dyu134/Paper-Apps-Player/production/bom.csv

Designator | Footprint | Quantity | Value | LCSC Part #
BT1 | Molex_PicoBlade_53048-0210_1x02_P1.25mm_Horizontal | 1 | Battery_Cell
C1 | 0603 | 1 | 15p
C10, C11, C12, C15, C18, C3, C4, C5, C9, L1 | 0603 | 10 | 10u
C13, C2, C6, C7, C8 | 0603 | 5 | 1u
C14 | 0603 | 1 | 0u1
C16, C17 | 0603 | 2 | 4u7
C19, C20 | 0603 | 2 | 100n
D2 | SOT-666 | 1 | USBLC6-2P6
D3 | 0603 | 1 | ORANGE
D4 | 0603 | 1 | RED
D5 | SOT-23 | 1 | BAT54S
D6, D7, D8 | D_SOD-123 | 3 | MBR0530T1G
D9 | LED_WS2812B_PLCC4_5.0x5.0mm_P3.2mm | 1 | WS2812B
J1 | USB_C_Receptacle_HCTL_HC-TYPE-C-16P-01A | 1 | USB_C_Receptacle_USB2.0_14P
J2 | Hirose_FH12-24S-0.5SH_1x24-1MP_P0.50mm_Horizontal | 1 | Conn_01x24_MountingPin
J3 | microSD_HC_Hirose_DM3AT-SF-PEJM5 | 1 | Micro_SD_Card_Det_Hirose_DM3AT
J4 | PinHeader_1x09_P2.54mm_Vertical | 1 | Conn_01x09
Q1 | SOT-723 | 1 | NTK3139P
Q2 | SOT-323_SC-70 | 1 | Si1308EDL
R1, R2 | 0402 | 2 | 10k
R11, R13 | 0603 | 2 | 100k
R12 | 0603 | 1 | 2k1
R14 | 0603 | 1 | 33k
R15 | 0603 | 1 | 1M
R16 | 0603 | 1 | 0R47
R17, R18, R19, R20, R21, R22, R8 | 0603 | 7 | 10k
R3, R4 | 0603 | 2 | 5k1
R5, R6 | 0603 | 2 | 4k7
R7, R9 | 0603 | 2 | 3k3
RN1, RN2 | R_Array_Convex_8x0602 | 2 | 10k
SW1, SW2 | SW_Push_1P1T_NO_Vertical_Wuerth_434133025816 | 2 | SKRPACE010
SW10, SW5, SW6, SW7, SW8, SW9 | SW_SPST_SKQG_WithStem | 6 | SW_Push
SW3 | SIQ-02FVS3 | 1 | SIQ-02FVS3
SW4 | SW_SPDT_CK_JS102011SAQN | 1 | JS102011SAQN
U1 | ESP32-S3-WROOM-1 | 1 | ESP32-S3-WROOM-1
U2, U4 | SOT-23-5 | 2 | MAX40200AUK
U3 | SOT-23-5_HandSoldering | 1 | TP4065
U5 | YHE-YG16-001_SH1B166A1 | 1 | YHE-YG16-001_SH1B166A1
U6 | SOT-23-5 | 1 | TLV75733PDBV
U7 | SSOP-20_5.3x7.2mm_P0.65mm | 1 | MCP23008-xSS
