dyu134/Paper-Apps-Player/Paper Apps Player.kicad_pcb

## KiCad design Paper Apps Player.kicad_pcb (2026-11-13)

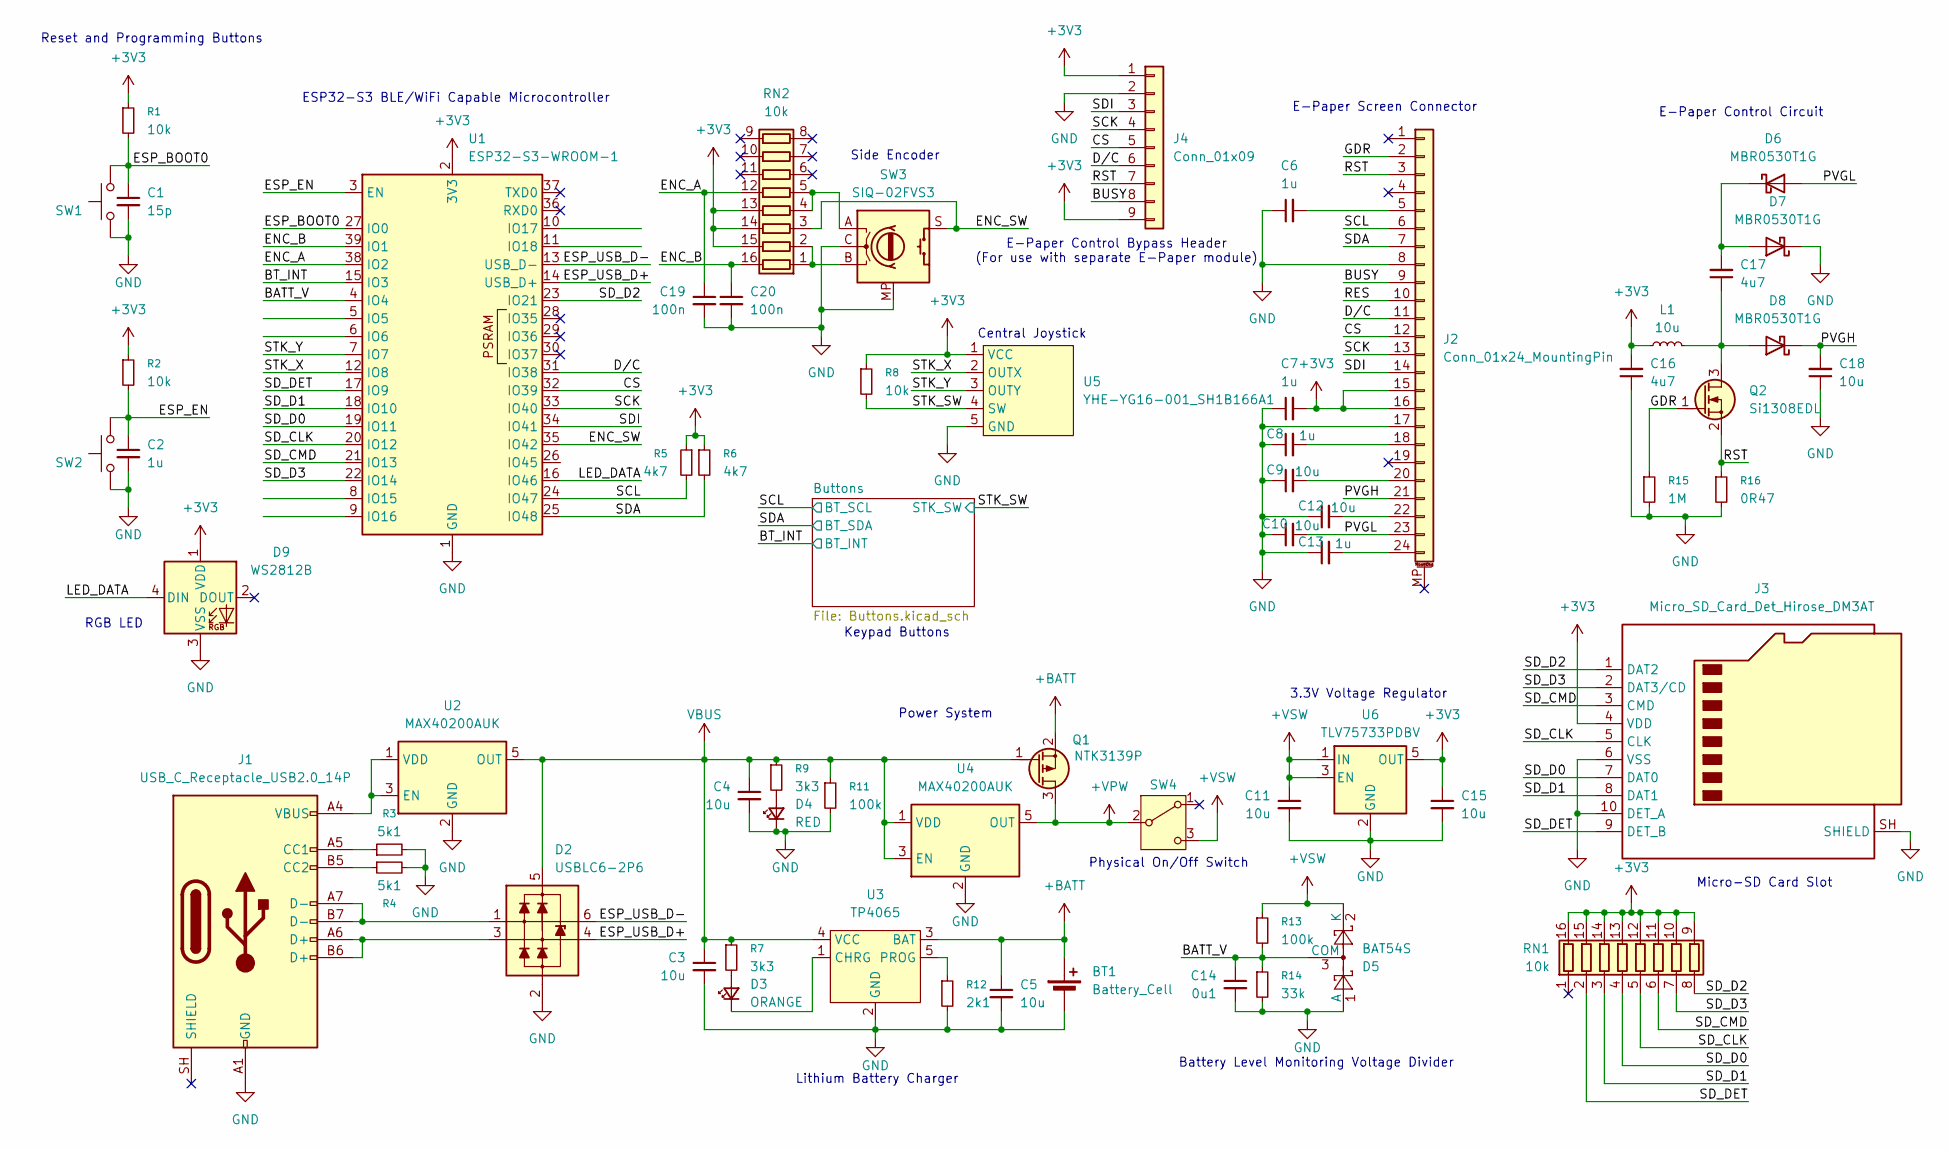
[picture p1: schematic Paper Apps Player.kicad_sch]

Parts:
BT1: Battery_Cell; Molex_PicoBlade_53048-0210_1x02_P1.25mm_Horizontal
C1: 15p; C_0603_1608Metric
C2, C6, C7, C8, C13: 1u; C_0603_1608Metric
C3, C4, C5, C9, C10, C11, C12, C15, C18: 10u; C_0603_1608Metric
C14: 0u1; C_0603_1608Metric
C16, C17: 4u7; C_0603_1608Metric
C19, C20: 100n; C_0603_1608Metric
D2: USBLC6-2P6; SOT-666
D3: ORANGE; LED_0603_1608Metric
D4: RED; LED_0603_1608Metric
D5: BAT54S; SOT-23
D6, D7, D8: MBR0530T1G; D_SOD-123
D9: WS2812B; LED_WS2812B_PLCC4_5.0x5.0mm_P3.2mm
J1: USB_C_Receptacle_USB2.0_14P; USB_C_Receptacle_HCTL_HC-TYPE-C-16P-01A
J2: Conn_01x24_MountingPin; Hirose_FH12-24S-0.5SH_1x24-1MP_P0.50mm_Horizontal
J3: Micro_SD_Card_Det_Hirose_DM3AT; microSD_HC_Hirose_DM3AT-SF-PEJM5
J4: Conn_01x09; PinHeader_1x09_P2.54mm_Vertical
L1: 10u; L_0603_1608Metric
Q1: NTK3139P; SOT-723
Q2: Si1308EDL; SOT-323_SC-70
R1, R2: 10k; R_0402_1005Metric
R3, R4: 5k1; R_0603_1608Metric
R5, R6: 4k7; R_0603_1608Metric
R7, R9: 3k3; R_0603_1608Metric
R8: 10k; R_0603_1608Metric
R11, R13: 100k; R_0603_1608Metric
R12: 2k1; R_0603_1608Metric
R14: 33k; R_0603_1608Metric
R15: 1M; R_0603_1608Metric
R16: 0R47; R_0603_1608Metric
RN1, RN2: 10k; R_Array_Convex_8x0602
SW1, SW2: SKRPACE010; SW_Push_1P1T_NO_Vertical_Wuerth_434133025816
SW3: SIQ-02FVS3
SW4: JS102011SAQN; SW_SPDT_CK_JS102011SAQN
U1: ESP32-S3-WROOM-1
U2, U4: MAX40200AUK; SOT-23-5
U3: TP4065; SOT-23-5_HandSoldering
U5: YHE-YG16-001_SH1B166A1
U6: TLV75733PDBV; SOT-23-5

Connections:
+3V3: C7.2, C15.1, C16.2, D9.1 (VDD), J2.15, J2.16, J3.4 (VDD), J4.1, J4.9, L1.1, R1.1, R2.1, R5.1, R6.1, R8.1, RN1.9 (R8.2), RN1.10 (R7.2), RN1.11 (R6.2), RN1.12 (R5.2), RN1.13 (R4.2), RN1.14 (R3.2), RN1.15 (R2.2), RN1.16 (R1.2), RN2.13 (R4.2), RN2.14 (R3.2), RN2.15 (R2.2), U1.2 (3V3), U5.1 (VCC), U6.5 (OUT); also elsewhere on the board
+BATT: BT1.1 (+), C5.1, Q1.2 (S), U3.3 (BAT)
+VPW: Q1.3 (D), SW4.2 (B), U4.5 (OUT)
+VSW: C11.1, D5.2 (K), R13.1, SW4.3 (C), U6.1 (IN), U6.3 (EN)
/BATT_V: C14.1, D5.3 (COM), R13.2, R14.1, U1.4 (IO4)
/BT_INT: U1.15 (IO3); also elsewhere on the board
/BUSY: J2.9, J4.8
/CS: J2.12, J4.5, U1.32 (IO39)
/D/C: J2.11, J4.6, U1.31 (IO38)
/ENC_A: C19.1, RN2.12 (R5.2), U1.38 (IO2)
/ENC_B: C20.1, RN2.16 (R1.2), U1.39 (IO1)
/ENC_SW: RN2.3 (R3.1), SW3.S, U1.35 (IO42)
/ESP_BOOT0: C1.1, R1.2, SW1.2, U1.27 (IO0)
/ESP_EN: C2.1, R2.2, SW2.2, U1.3 (EN)
/ESP_USB_D+: D2.4 (L2), U1.14 (USB_D+)
/ESP_USB_D-: D2.6 (L1), U1.13 (USB_D-)
/GDR: J2.2, Q2.1 (G), R15.1
/LED_DATA: D9.4 (DIN), U1.16 (IO46)
/PVGH: C18.2, D8.1 (K), J2.21
/PVGL: C10.2, D6.2 (A), J2.23
/RES: J2.10
/RST: J2.3, J4.7, Q2.2 (S), R16.1
/SCK: J2.13, J4.4, U1.33 (IO40)
/SCL: J2.6, R5.2, U1.24 (IO47); also elsewhere on the board
/SDA: J2.7, R6.2, U1.25 (IO48); also elsewhere on the board
/SDI: J2.14, J4.3, U1.34 (IO41)
/SD_CLK: J3.5 (CLK), RN1.5 (R5.1), U1.20 (IO12)
/SD_CMD: J3.3 (CMD), RN1.6 (R6.1), U1.21 (IO13)
/SD_D0: J3.7 (DAT0), RN1.4 (R4.1), U1.19 (IO11)
/SD_D1: J3.8 (DAT1), RN1.3 (R3.1), U1.18 (IO10)
/SD_D2: J3.1 (DAT2), RN1.8 (R8.1), U1.23 (IO21)
/SD_D3: J3.2 (DAT3/CD), RN1.7 (R7.1), U1.22 (IO14)
/SD_DET: J3.9 (DET_B), RN1.2 (R2.1), U1.17 (IO9)
/STK_SW: R8.2, U5.4 (SW); also elsewhere on the board
/STK_X: U1.12 (IO8), U5.2 (OUTX)
/STK_Y: U1.7 (IO7), U5.3 (OUTY)
GND: BT1.2 (-), C1.2, C2.2, C3.2, C4.2, C5.2, C6.1, C7.1, C8.1, C9.1, C10.1, C11.2, C12.1, C13.1, C14.2, C15.2, C16.1, C18.1, C19.2, C20.2, D2.2 (VN), D4.1 (K), D5.1 (A), D7.1 (K), D9.3 (VSS), J1.A1 (GND), J1.A12 (GND), J1.B1 (GND), J1.B12 (GND), J2.8, J2.17, J3.6 (VSS), J3.10 (DET_A), J3.SH (SHIELD), J4.2, R3.2, R4.2, R11.2, R12.2, R14.2, R15.2, R16.2, SW1.1, SW2.1, SW3.C, SW3.MP, U1.1 (GND), U1.40 (GND), U1.41 (GND), U2.2 (GND), U3.2 (GND), U4.2 (GND), U5.5 (GND), U6.2 (GND); also elsewhere on the board
unnamed: D2.1 (L1), J1.A7 (D-), J1.B7 (D-)
unnamed: D2.3 (L2), J1.A6 (D+), J1.B6 (D+)
unnamed: D3.2 (A), R7.2
unnamed: D3.1 (K), U3.1 (CHRG)
unnamed: D4.2 (A), R9.2
unnamed: C17.2, D6.1 (K), D7.2 (A)
unnamed: C17.1, D8.2 (A), L1.2, Q2.3 (D)
unnamed: J1.A5 (CC1), R3.1
unnamed: J1.B5 (CC2), R4.1
unnamed: C6.2, J2.5
unnamed: C8.2, J2.18
unnamed: C9.2, J2.20
unnamed: C12.2, J2.22
unnamed: C13.2, J2.24
unnamed: RN2.1 (R1.1), RN2.2 (R2.1), SW3.B
unnamed: RN2.4 (R4.1), RN2.5 (R5.1), SW3.A
unnamed: J1.A4 (VBUS), J1.A9 (VBUS), J1.B4 (VBUS), J1.B9 (VBUS), U2.1 (VDD), U2.3 (EN)
unnamed: R12.1, U3.5 (PROG)
VBUS: C3.1, C4.1, D2.5 (VP), Q1.1 (G), R7.1, R9.1, R11.1, U2.5 (OUT), U3.4 (VCC), U4.1 (VDD), U4.3 (EN)

Notes on the sheet:
Physical On/Off Switch
E-Paper Control Bypass Header (For use with separate E-Paper module)
Power System
Reset and Programming Buttons
Micro-SD Card Slot
Central Joystick
E-Paper Screen Connector
E-Paper Control Circuit
3.3V Voltage Regulator
RGB LED
Keypad Buttons
Lithium Battery Charger
Battery Level Monitoring Voltage Divider
ESP32-S3 BLE/WiFi Capable Microcontroller
Side Encoder

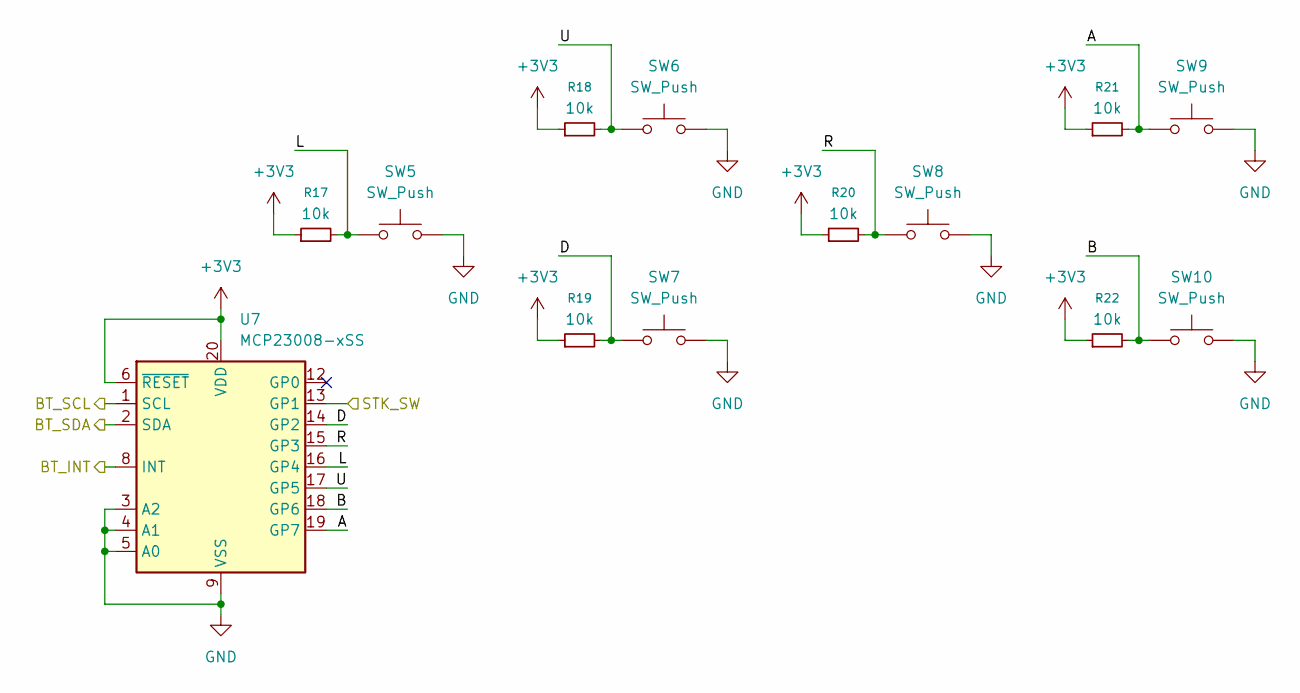
[picture p2: schematic Buttons.kicad_sch]

Parts:
R17, R18, R19, R20, R21, R22: 10k; R_0603_1608Metric
SW5, SW6, SW7, SW8, SW9, SW10: SW_Push; SW_SPST_SKQG_WithStem
U7: MCP23008-xSS; SSOP-20_5.3x7.2mm_P0.65mm

Connections:
+3V3: R17.1, R18.1, R19.1, R20.1, R21.1, R22.1, U7.6 (~RESET), U7.20 (VDD); also elsewhere on the board
/BT_INT: U7.8 (INT); also elsewhere on the board
/Buttons/A: R21.2, SW9.1, U7.19 (GP7)
/Buttons/B: R22.2, SW10.1, U7.18 (GP6)
/Buttons/D: R19.2, SW7.1, U7.14 (GP2)
/Buttons/L: R17.2, SW5.1, U7.16 (GP4)
/Buttons/R: R20.2, SW8.1, U7.15 (GP3)
/Buttons/U: R18.2, SW6.1, U7.17 (GP5)
/SCL: U7.1 (SCL); also elsewhere on the board
/SDA: U7.2 (SDA); also elsewhere on the board
/STK_SW: U7.13 (GP1); also elsewhere on the board
GND: SW5.2, SW6.2, SW7.2, SW8.2, SW9.2, SW10.2, U7.3 (A2), U7.4 (A1), U7.5 (A0), U7.9 (VSS); also elsewhere on the board

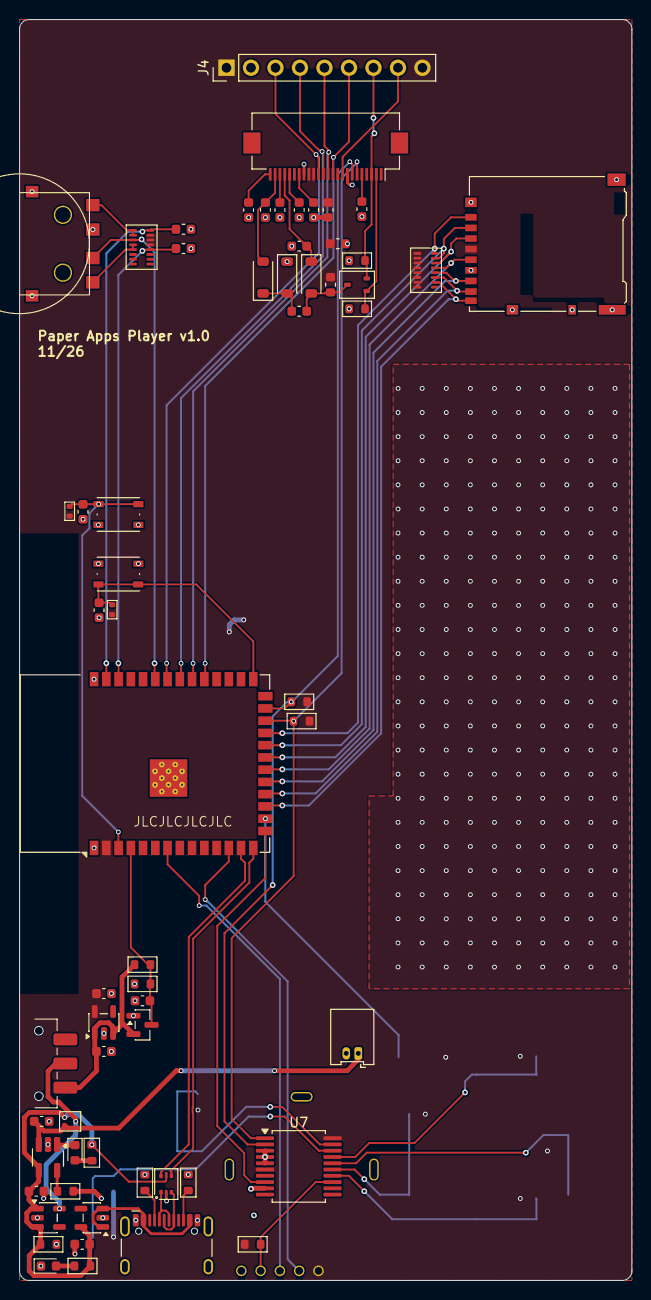
[picture p3: board Paper Apps Player.kicad_pcb from above]

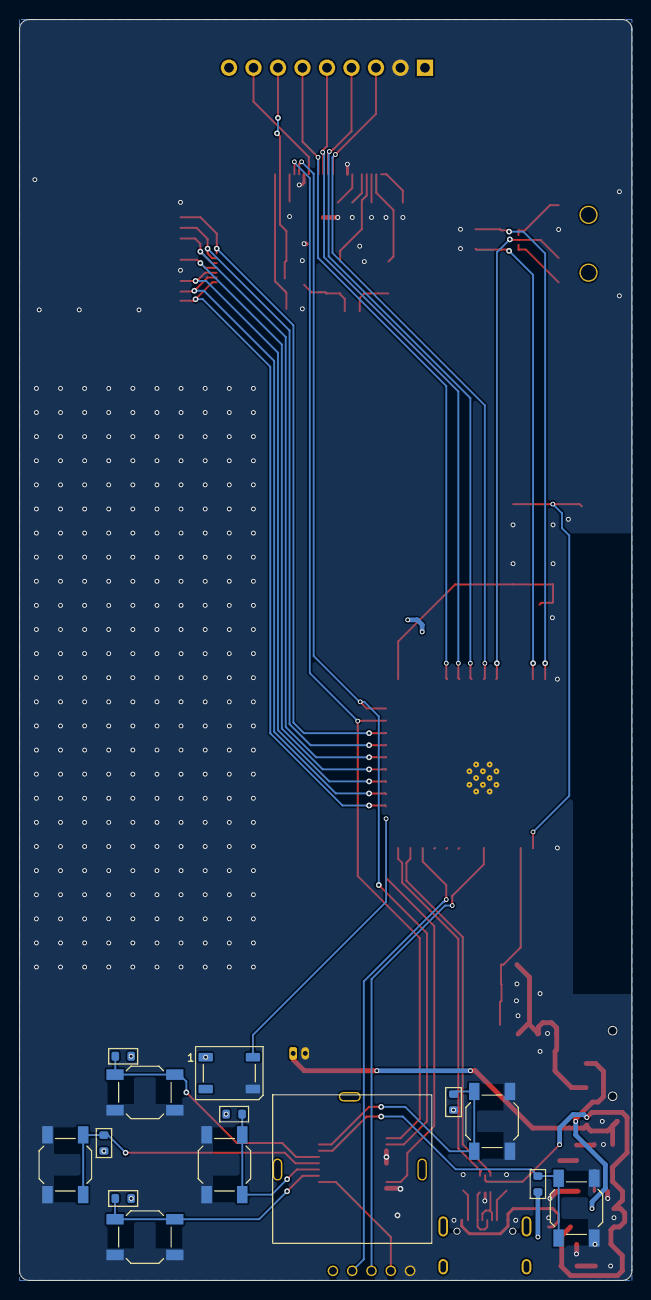
[picture p4: board Paper Apps Player.kicad_pcb from below]

Board: 2 copper layers, 63.5 x 130.8 mm, 76 parts (14 on the bottom side), 61 nets.
