dyu134/Paper-Apps-Player/(commit log)

2026-11-13 initial commit Paper Apps Player v1.0: gamepad player for simple notebook style games using an e-paper screen
    [Audio.kicad_sch, Buttons.kicad_sch, Paper Apps Player.kicad_pcb, Paper Apps Player.kicad_sch, bom.csv, designators.csv, positions.csv]
2026-11-13 Added notes on schematic and layout for reference
    [Paper Apps Player.kicad_pcb, Paper Apps Player.kicad_sch]
